redjoj/lriethernet-copy/README.md

Project Documentation:
https://docs.google.com/document/d/17A6YyLQIsLVnjUdbRW_1tglquppojlsUYxg8EC6wMic/edit?tab=t.0
