redjoj/lriethernet-copy/LRIEthernet.kicad_pcb

## KiCad design LRIEthernet.kicad_pcb (2026-02-13)

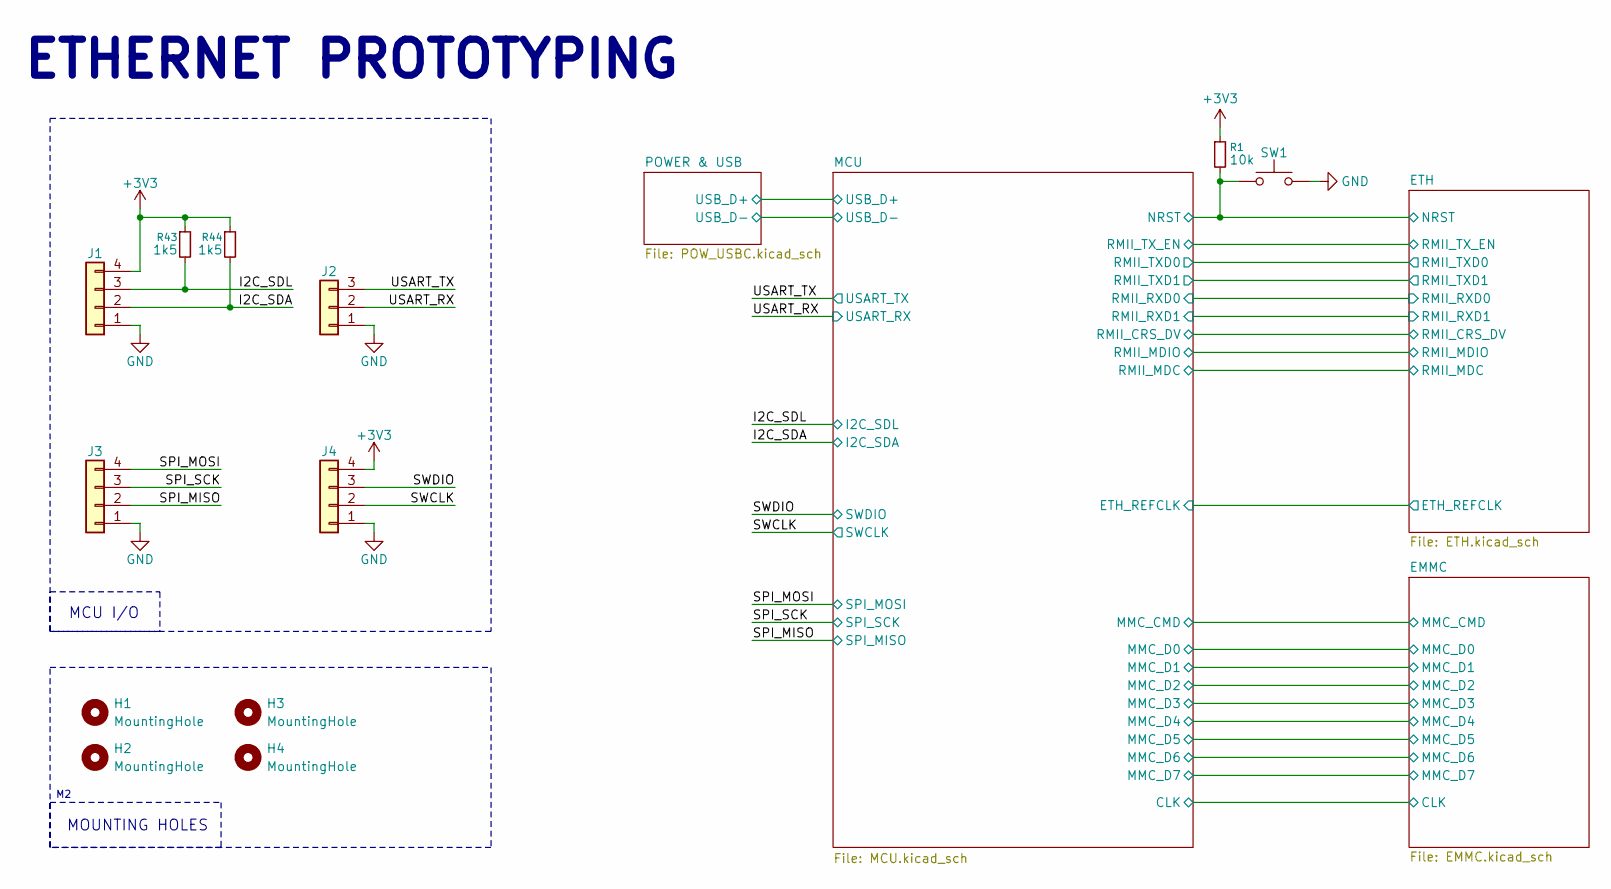
[picture p1: schematic LRIEthernet.kicad_sch, Ethernet Prototyping Hierarchical View]

Parts:
H1, H2, H3, H4: MountingHole; MountingHole_2.2mm_M2
J1, J3, J4: Conn_01x04; PinHeader_1x04_P2.54mm_Vertical
J2: Conn_01x03; PinHeader_1x03_P2.54mm_Vertical
R1: 10k; R_0603_1608Metric
R43, R44: 1k5; R_0603_1608Metric
SW1: SW_Push; SW_TS-1088_XNP

Connections:
+3V3: J1.4, J4.4, R1.1, R43.1, R44.1; also elsewhere on the board
/ETH/NRST: R1.2, SW1.1; also elsewhere on the board
/I2C_SDA: J1.2, R44.2; also elsewhere on the board
/I2C_SDL: J1.3, R43.2; also elsewhere on the board
/SPI_MISO: J3.2; also elsewhere on the board
/SPI_MOSI: J3.4; also elsewhere on the board
/SPI_SCK: J3.3; also elsewhere on the board
/SWCLK: J4.2; also elsewhere on the board
/SWDIO: J4.3; also elsewhere on the board
/USART_RX: J2.2; also elsewhere on the board
/USART_TX: J2.3; also elsewhere on the board
GND: J1.1, J2.1, J3.1, J4.1, SW1.2; also elsewhere on the board

Notes on the sheet:
ETHERNET PROTOTYPING
MCU I/O
MOUNTING HOLES

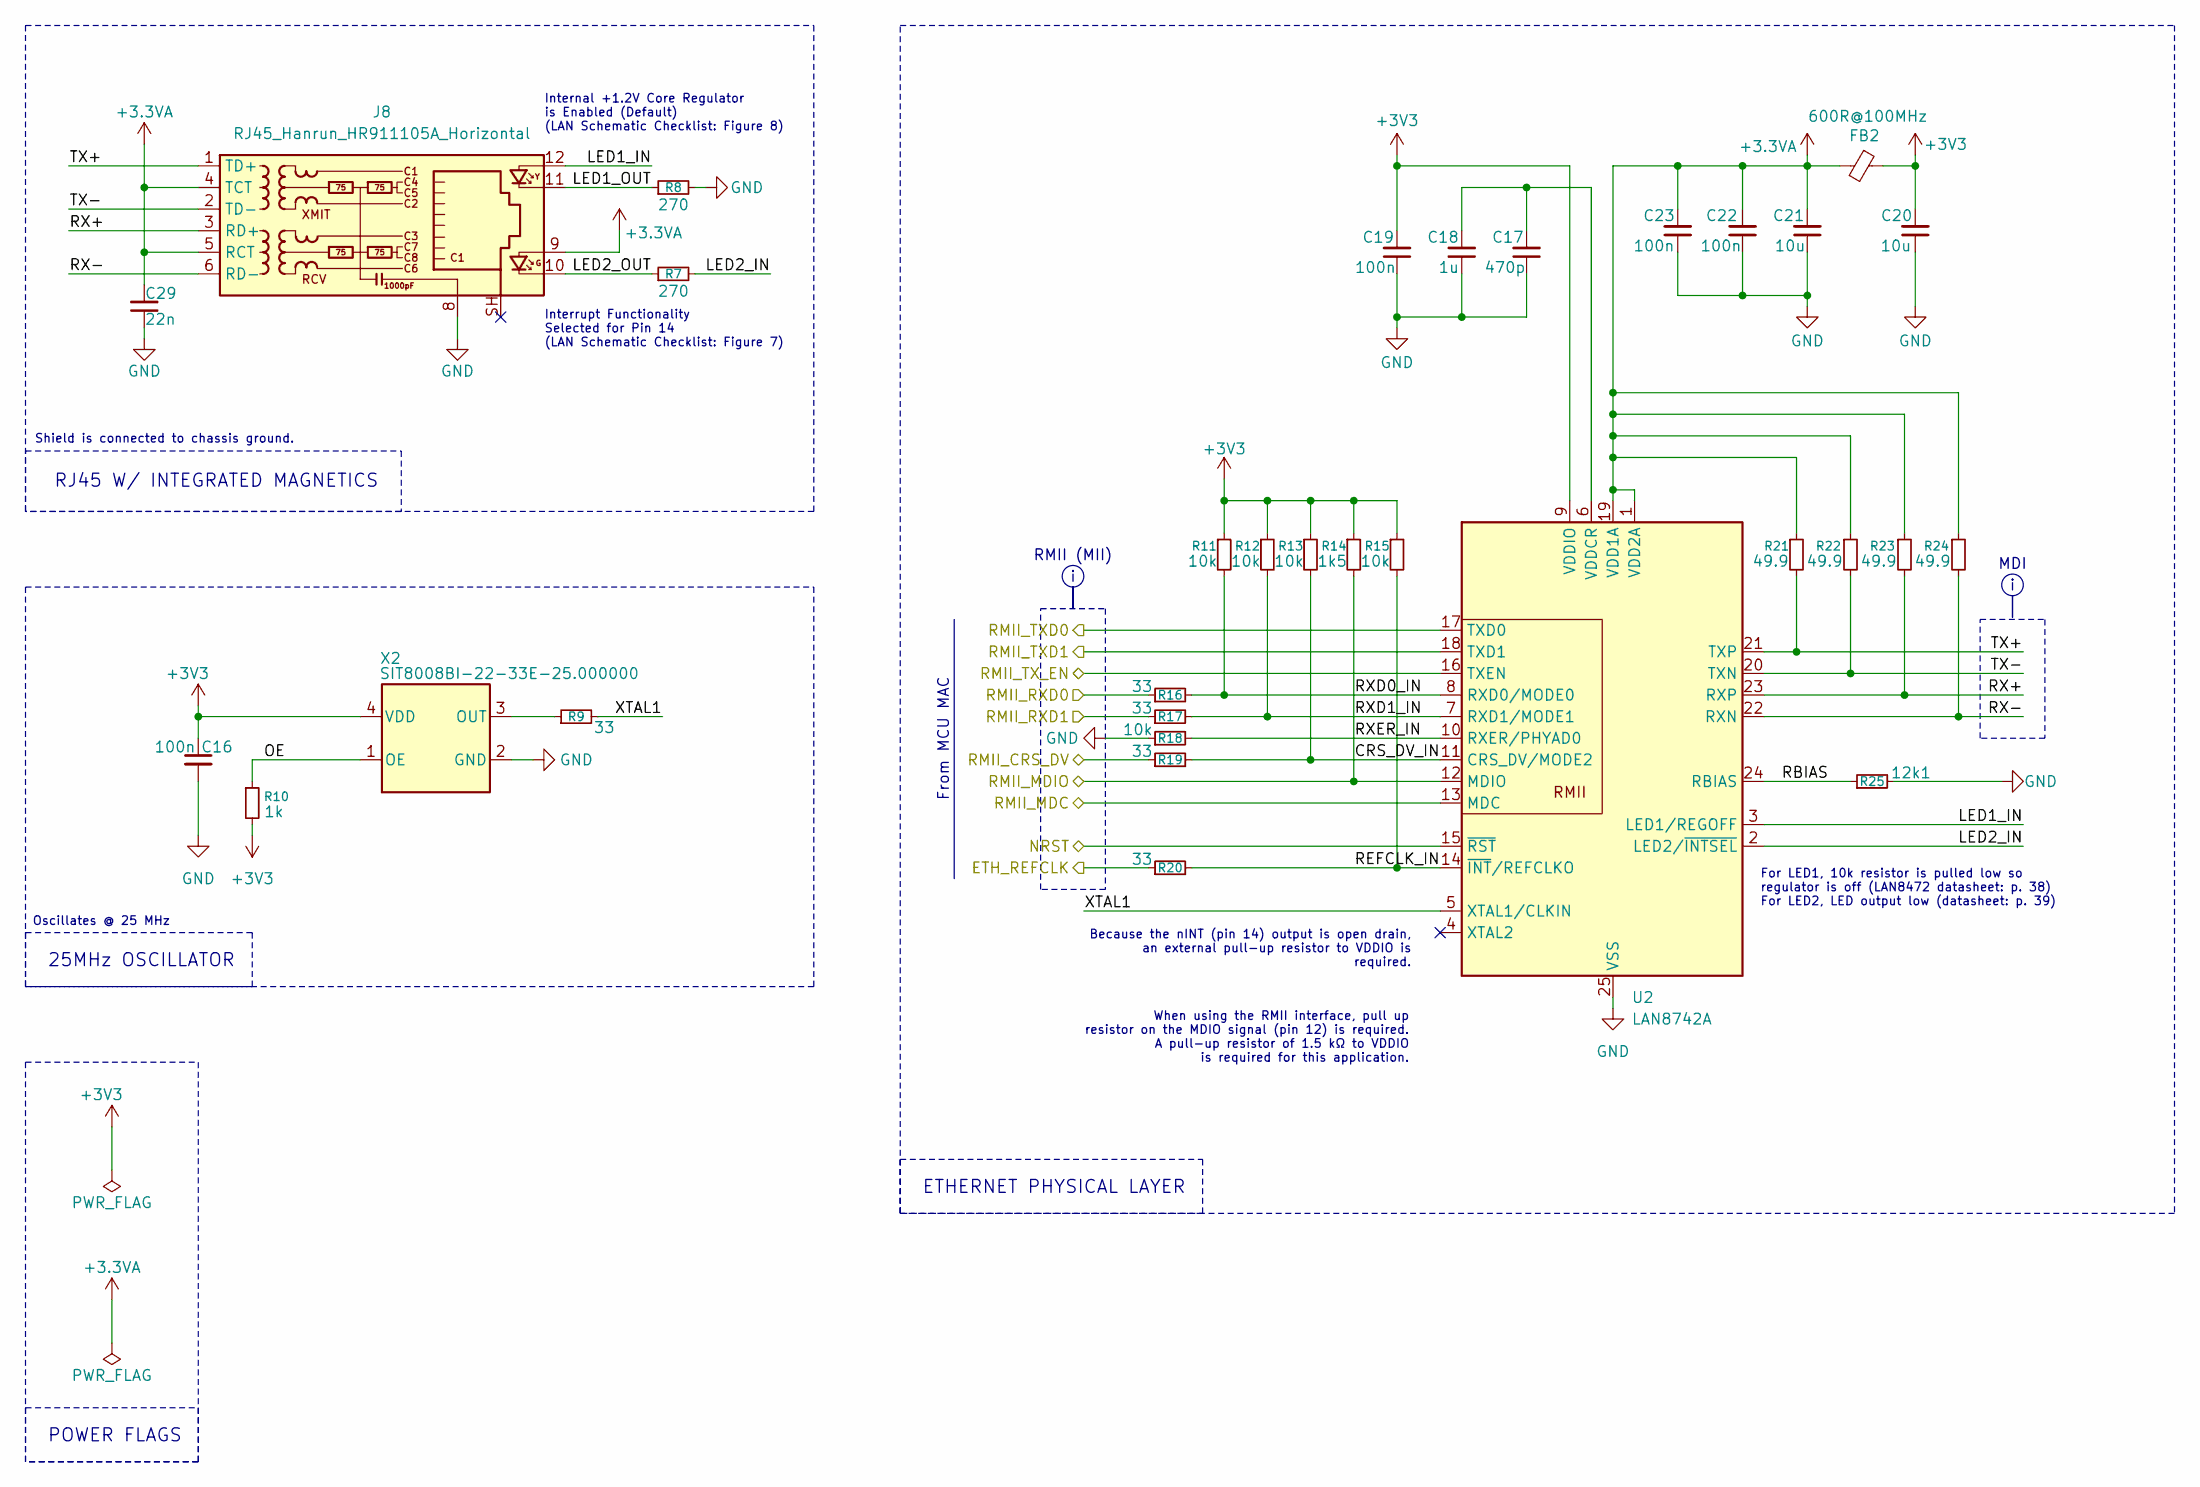
[picture p2: schematic ETH.kicad_sch, Ethernet]

Parts:
C16: 100n; C_0603_1608Metric
C17: 470p; C_0603_1608Metric
C18: 1u; C_0603_1608Metric
C19, C22, C23: 100n; C_0402_1005Metric
C20, C21: 10u; C_0603_1608Metric
C29: 22n; C_0603_1608Metric
FB2: 600R@100MHz; L_0603_1608Metric
J8: RJ45_Hanrun_HR911105A_Horizontal
R7, R8: 270; R_0603_1608Metric
R9, R16, R17, R19, R20: 33; R_0603_1608Metric
R10: 1k; R_0603_1608Metric
R11, R12, R13, R15, R18: 10k; R_0603_1608Metric
R14: 1k5; R_0603_1608Metric
R21, R22, R23, R24: 49.9; R_0603_1608Metric
R25: 12k1; R_0603_1608Metric
U2: LAN8742A; VQFN-24-1EP_4x4mm_P0.5mm_EP2.5x2.5mm_ThermalVias
X2: SIT8008BI-22-33E-25.000000; SON4_SIT8008BI_3.2x2.5_SIT

Connections:
+3.3VA: C21.2, C22.2, C23.2, C29.2, FB2.2, J8.4 (TCT), J8.5 (RCT), J8.9, R21.1, R22.1, R23.1, R24.1, U2.1 (VDD2A), U2.19 (VDD1A)
+3V3: C16.1, C19.2, C20.2, FB2.1, R10.2, R11.1, R12.1, R13.1, R14.1, R15.1, U2.9 (VDDIO), X2.4 (VDD); also elsewhere on the board
/ETH/ETH_REFCLK: R20.1; also elsewhere on the board
/ETH/LED1_IN: J8.12, U2.3 (LED1/REGOFF)
/ETH/LED1_OUT: J8.11, R8.1
/ETH/LED2_IN: R7.2, U2.2 (LED2/~INTSEL)
/ETH/LED2_OUT: J8.10, R7.1
/ETH/NRST: U2.15 (~RST); also elsewhere on the board
/ETH/OE: R10.1, X2.1 (OE)
/ETH/RBIAS: R25.1, U2.24 (RBIAS)
/ETH/REFCLK_IN: R15.2, R20.2, U2.14 (~INT/REFCLKO)
/ETH/RMII_CRS_DV: R19.1; also elsewhere on the board
/ETH/RMII_MDC: U2.13 (MDC); also elsewhere on the board
/ETH/RMII_RXD0: R16.1; also elsewhere on the board
/ETH/RMII_RXD1: R17.1; also elsewhere on the board
/ETH/RMII_TXD0: U2.17 (TXD0); also elsewhere on the board
/ETH/RMII_TXD1: U2.18 (TXD1); also elsewhere on the board
/ETH/RMII_TX_EN: U2.16 (TXEN); also elsewhere on the board
/ETH/RX+: J8.3 (RD+), R23.2, U2.23 (RXP)
/ETH/RX-: J8.6 (RD-), R24.2, U2.22 (RXN)
/ETH/TX+: J8.1 (TD+), R21.2, U2.21 (TXP)
/ETH/TX-: J8.2 (TD-), R22.2, U2.20 (TXN)
/ETH/XTAL1: R9.2, U2.5 (XTAL1/CLKIN)
GND: C16.2, C17.1, C18.1, C19.1, C20.1, C21.1, C22.1, C23.1, C29.1, J8.8, R8.2, R18.1, R25.2, U2.25 (VSS), X2.2 (GND); also elsewhere on the board
unnamed: C17.2, C18.2, U2.6 (VDDCR)
unnamed: R9.1, X2.3 (OUT)

Notes on the sheet:
POWER FLAGS
From MCU MAC
ETHERNET PHYSICAL LAYER
RJ45 W/ INTEGRATED MAGNETICS
Shield is connected to chassis ground.
For LED1, 10k resistor is pulled low so regulator is off (LAN8472 datasheet: p. 38) For LED2, LED output low (datasheet: p. 39)
Interrupt Functionality Selected for Pin 14 (LAN Schematic Checklist: Figure 7)
When using the RMII interface, pull up resistor on the MDIO signal (pin 12) is required. A pull-up resistor of 1.5 kΩ to VDDIO is required for this application.
RMII (MII)
25MHz OSCILLATOR
Oscillates @ 25 MHz
MDI
Internal +1.2V Core Regulator is Enabled (Default) (LAN Schematic Checklist: Figure 8)
Because the nINT (pin 14) output is open drain, an external pull-up resistor to VDDIO is required.

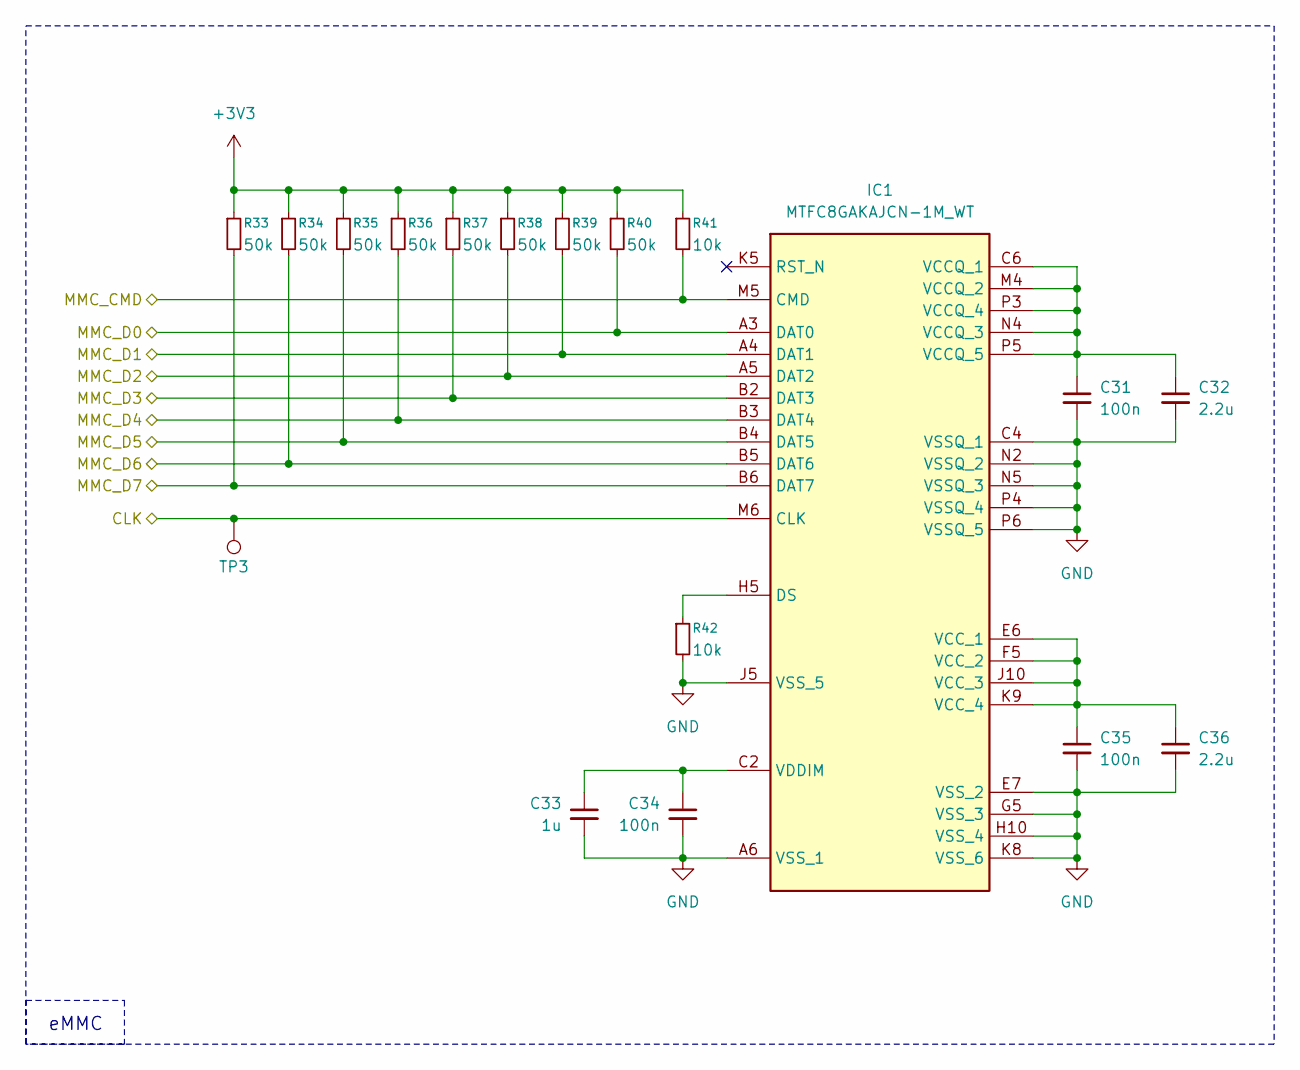
[picture p3: schematic EMMC.kicad_sch]

Parts:
C31, C34, C35: 100n; C_0402_1005Metric
C32, C36: 2.2u; C_0603_1608Metric
C33: 1u; C_0603_1608Metric
IC1: MTFC8GAKAJCN-1M_WT; VFBGA153_11p5X13p0X1p0_CN_MRN; Manufacturer_Part_Number MTFC8GAKAJCN-1M WT; Mouser Part Number 340-296537-TRAY
R33, R34, R35, R36, R37, R38, R39, R40: 50k; R_0603_1608Metric
R41, R42: 10k; R_0603_1608Metric
TP3: TestPoint; TestPoint_Pad_D1.0mm

Connections:
+3V3: R33.1, R34.1, R35.1, R36.1, R37.1, R38.1, R39.1, R40.1, R41.1; also elsewhere on the board
/EMMC/CLK: IC1.M6 (CLK), TP3.1; also elsewhere on the board
/EMMC/MMC_CMD: IC1.M5 (CMD), R41.2; also elsewhere on the board
/EMMC/MMC_D0: IC1.A3 (DAT0), R40.2; also elsewhere on the board
/EMMC/MMC_D1: IC1.A4 (DAT1), R39.2; also elsewhere on the board
/EMMC/MMC_D2: IC1.A5 (DAT2), R38.2; also elsewhere on the board
/EMMC/MMC_D3: IC1.B2 (DAT3), R37.2; also elsewhere on the board
/EMMC/MMC_D4: IC1.B3 (DAT4), R36.2; also elsewhere on the board
/EMMC/MMC_D5: IC1.B4 (DAT5), R35.2; also elsewhere on the board
/EMMC/MMC_D6: IC1.B5 (DAT6), R34.2; also elsewhere on the board
/EMMC/MMC_D7: IC1.B6 (DAT7), R33.2; also elsewhere on the board
GND: C31.2, C32.2, C33.2, C34.2, C35.2, C36.2, IC1.A6 (VSS_1), IC1.C4 (VSSQ_1), IC1.E7 (VSS_2), IC1.G5 (VSS_3), IC1.H10 (VSS_4), IC1.J5 (VSS_5), IC1.K8 (VSS_6), IC1.N2 (VSSQ_2), IC1.N5 (VSSQ_3), IC1.P4 (VSSQ_4), IC1.P6 (VSSQ_5), R42.2; also elsewhere on the board
unnamed: IC1.H5 (DS), R42.1
unnamed: C31.1, C32.1, IC1.C6 (VCCQ_1), IC1.M4 (VCCQ_2), IC1.N4 (VCCQ_3), IC1.P3 (VCCQ_4), IC1.P5 (VCCQ_5)
unnamed: C35.1, C36.1, IC1.E6 (VCC_1), IC1.F5 (VCC_2), IC1.J10 (VCC_3), IC1.K9 (VCC_4)
unnamed: C33.1, C34.1, IC1.C2 (VDDIM)

Notes on the sheet:
eMMC

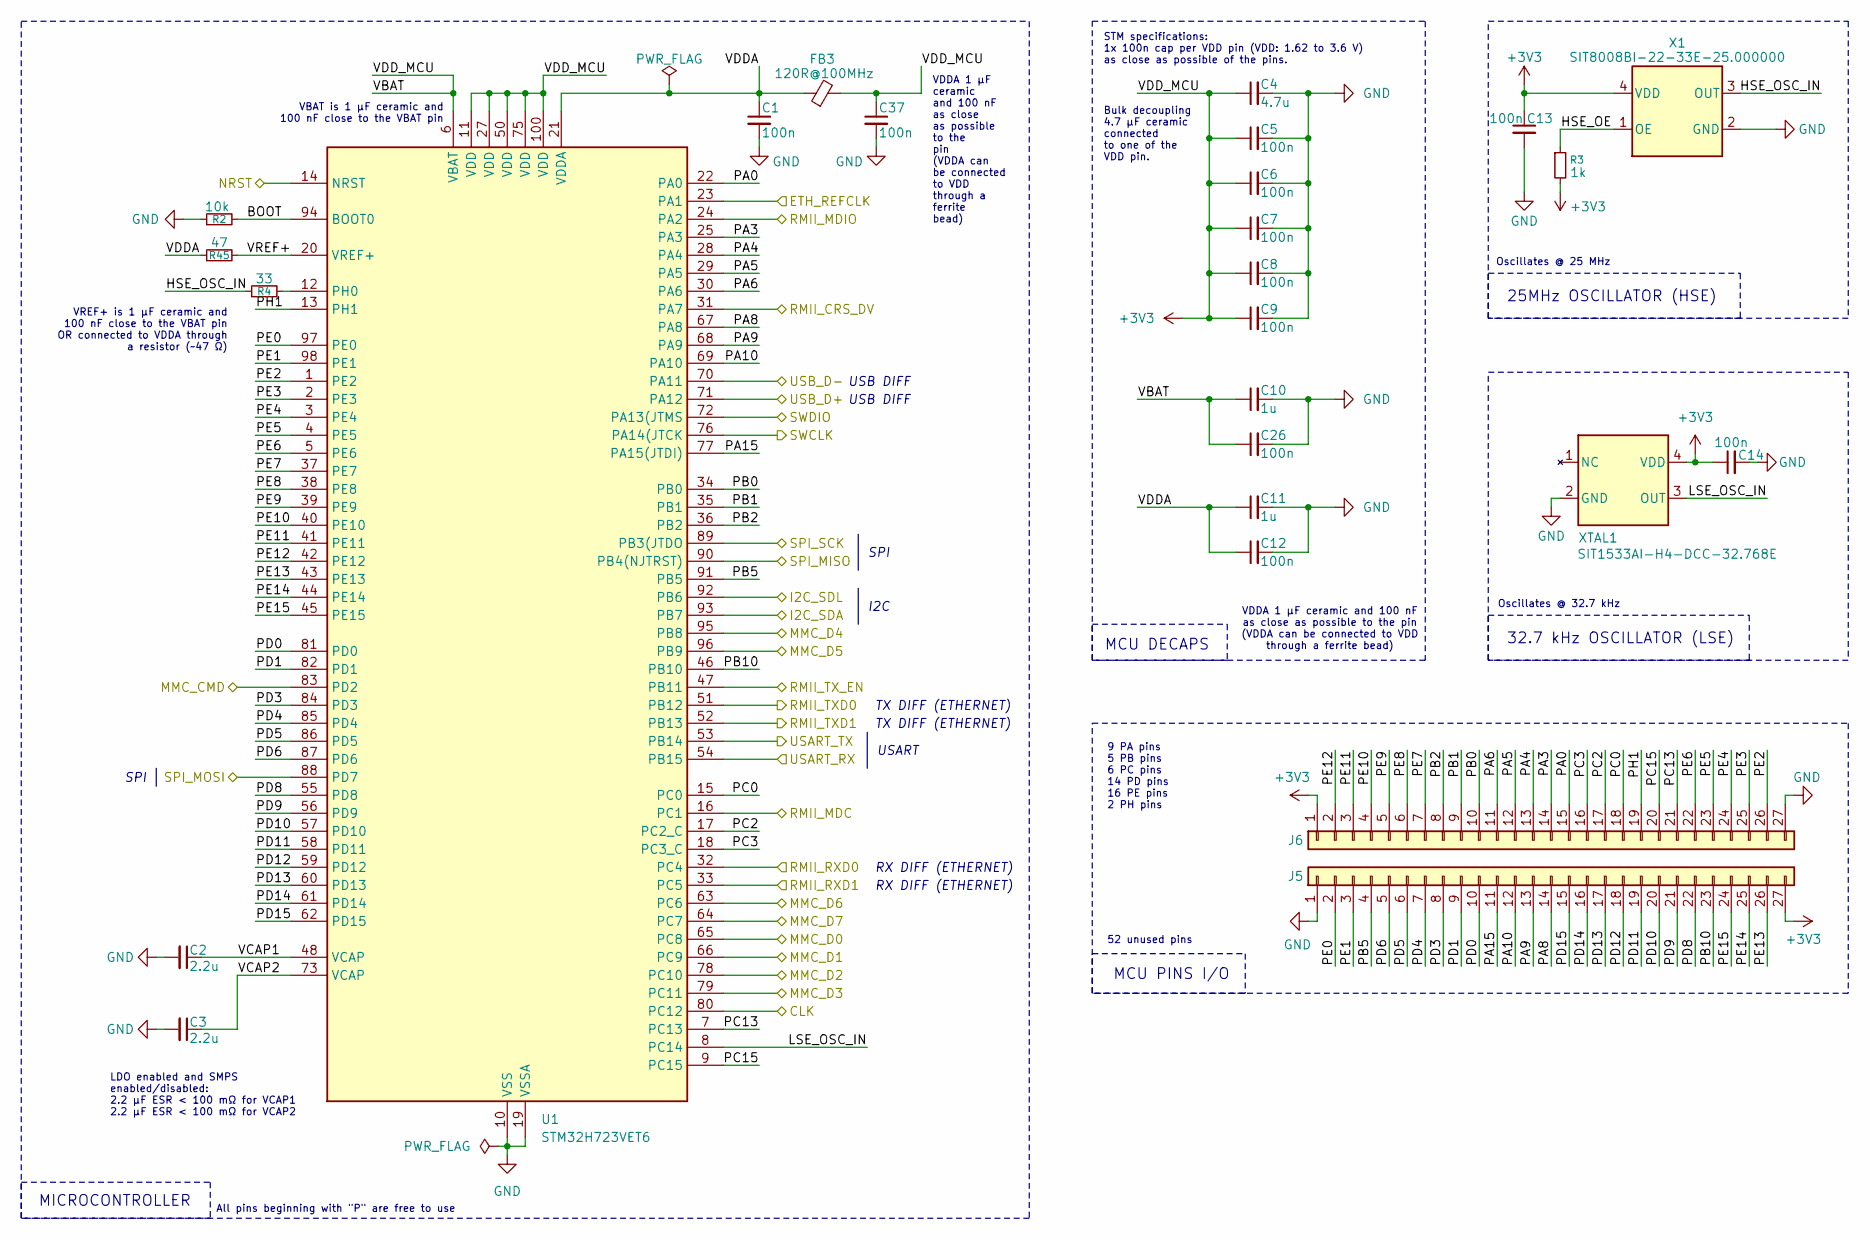
[picture p4: schematic MCU.kicad_sch, Microcontroller]

Parts:
C1, C5, C6, C7, C8, C9, C12, C13, C14, C26, C37: 100n; C_0402_1005Metric
C2, C3: 2.2u; C_0603_1608Metric
C4: 4.7u; C_0603_1608Metric
C10, C11: 1u; C_0603_1608Metric
FB3: 120R@100MHz; L_0603_1608Metric
J5, J6: Conn_01x27; PinHeader_1x27_P2.54mm_Vertical
R2: 10k; R_0603_1608Metric
R3: 1k; R_0603_1608Metric
R4: 33; R_0603_1608Metric
R45: 47; R_0603_1608Metric
U1: STM32H723VET6; LQFP-100_14x14mm_P0.5mm
X1: SIT8008BI-22-33E-25.000000; SON4_SIT8008BI_3.2x2.5_SIT
XTAL1: SIT1533AI-H4-DCC-32.768E; XTAL4_SiT1533_SIT

Connections:
+3V3: C4.1, C5.1, C6.1, C7.1, C8.1, C9.1, C10.1, C13.1, C14.1, C26.1, C37.1, FB3.2, J5.27, J6.1, R3.2, U1.6 (VBAT), U1.11 (VDD), U1.27 (VDD), U1.50 (VDD), U1.75 (VDD), U1.100 (VDD), X1.4 (VDD), XTAL1.4 (VDD); also elsewhere on the board
/EMMC/CLK: U1.80 (PC12); also elsewhere on the board
/EMMC/MMC_CMD: U1.83 (PD2); also elsewhere on the board
/EMMC/MMC_D0: U1.65 (PC8); also elsewhere on the board
/EMMC/MMC_D1: U1.66 (PC9); also elsewhere on the board
/EMMC/MMC_D2: U1.78 (PC10); also elsewhere on the board
/EMMC/MMC_D3: U1.79 (PC11); also elsewhere on the board
/EMMC/MMC_D4: U1.95 (PB8); also elsewhere on the board
/EMMC/MMC_D5: U1.96 (PB9); also elsewhere on the board
/EMMC/MMC_D6: U1.63 (PC6); also elsewhere on the board
/EMMC/MMC_D7: U1.64 (PC7); also elsewhere on the board
/ETH/ETH_REFCLK: U1.23 (PA1); also elsewhere on the board
/ETH/NRST: U1.14 (NRST); also elsewhere on the board
/ETH/RMII_CRS_DV: U1.31 (PA7); also elsewhere on the board
/ETH/RMII_MDC: U1.16 (PC1); also elsewhere on the board
/ETH/RMII_RXD0: U1.32 (PC4); also elsewhere on the board
/ETH/RMII_RXD1: U1.33 (PC5); also elsewhere on the board
/ETH/RMII_TXD0: U1.51 (PB12); also elsewhere on the board
/ETH/RMII_TXD1: U1.52 (PB13); also elsewhere on the board
/ETH/RMII_TX_EN: U1.47 (PB11); also elsewhere on the board
/I2C_SDA: U1.93 (PB7); also elsewhere on the board
/I2C_SDL: U1.92 (PB6); also elsewhere on the board
/MCU/BOOT: R2.2, U1.94 (BOOT0)
/MCU/HSE_OE: R3.1, X1.1 (OE)
/MCU/HSE_OSC_IN: R4.1, X1.3 (OUT)
/MCU/LSE_OSC_IN: U1.8 (PC14), XTAL1.3 (OUT)
/MCU/PA0: J6.15, U1.22 (PA0)
/MCU/PA3: J6.14, U1.25 (PA3)
/MCU/PA4: J6.13, U1.28 (PA4)
/MCU/PA5: J6.12, U1.29 (PA5)
/MCU/PA6: J6.11, U1.30 (PA6)
/MCU/PA8: J5.14, U1.67 (PA8)
/MCU/PA9: J5.13, U1.68 (PA9)
/MCU/PA10: J5.12, U1.69 (PA10)
/MCU/PA15: J5.11, U1.77 (PA15(JTDI))
/MCU/PB0: J6.10, U1.34 (PB0)
/MCU/PB1: J6.9, U1.35 (PB1)
/MCU/PB2: J6.8, U1.36 (PB2)
/MCU/PB5: J5.4, U1.91 (PB5)
/MCU/PB10: J5.23, U1.46 (PB10)
/MCU/PC0: J6.18, U1.15 (PC0)
/MCU/PC2: J6.17, U1.17 (PC2_C)
/MCU/PC3: J6.16, U1.18 (PC3_C)
/MCU/PC13: J6.21, U1.7 (PC13)
/MCU/PC15: J6.20, U1.9 (PC15)
/MCU/PD0: J5.10, U1.81 (PD0)
/MCU/PD1: J5.9, U1.82 (PD1)
/MCU/PD3: J5.8, U1.84 (PD3)
/MCU/PD4: J5.7, U1.85 (PD4)
/MCU/PD5: J5.6, U1.86 (PD5)
/MCU/PD6: J5.5, U1.87 (PD6)
/MCU/PD8: J5.22, U1.55 (PD8)
/MCU/PD9: J5.21, U1.56 (PD9)
/MCU/PD10: J5.20, U1.57 (PD10)
/MCU/PD11: J5.19, U1.58 (PD11)
/MCU/PD12: J5.18, U1.59 (PD12)
/MCU/PD13: J5.17, U1.60 (PD13)
/MCU/PD14: J5.16, U1.61 (PD14)
/MCU/PD15: J5.15, U1.62 (PD15)
/MCU/PE0: J5.2, U1.97 (PE0)
/MCU/PE1: J5.3, U1.98 (PE1)
/MCU/PE2: J6.26, U1.1 (PE2)
/MCU/PE3: J6.25, U1.2 (PE3)
/MCU/PE4: J6.24, U1.3 (PE4)
/MCU/PE5: J6.23, U1.4 (PE5)
/MCU/PE6: J6.22, U1.5 (PE6)
/MCU/PE7: J6.7, U1.37 (PE7)
/MCU/PE8: J6.6, U1.38 (PE8)
/MCU/PE9: J6.5, U1.39 (PE9)
/MCU/PE10: J6.4, U1.40 (PE10)
/MCU/PE11: J6.3, U1.41 (PE11)
/MCU/PE12: J6.2, U1.42 (PE12)
/MCU/PE13: J5.26, U1.43 (PE13)
/MCU/PE14: J5.25, U1.44 (PE14)
/MCU/PE15: J5.24, U1.45 (PE15)
/MCU/PH1: J6.19, U1.13 (PH1)
/MCU/USB_D+: U1.71 (PA12); also elsewhere on the board
/MCU/USB_D-: U1.70 (PA11); also elsewhere on the board
/MCU/VCAP1: C2.1, U1.48 (VCAP)
/MCU/VCAP2: C3.1, U1.73 (VCAP)
/MCU/VDDA: C1.1, C11.1, C12.1, FB3.1, R45.1, U1.21 (VDDA)
/MCU/VREF+: R45.2, U1.20 (VREF+)
/SPI_MISO: U1.90 (PB4(NJTRST)); also elsewhere on the board
/SPI_MOSI: U1.88 (PD7); also elsewhere on the board
/SPI_SCK: U1.89 (PB3(JTDO); also elsewhere on the board
/SWCLK: U1.76 (PA14(JTCK); also elsewhere on the board
/SWDIO: U1.72 (PA13(JTMS); also elsewhere on the board
/USART_RX: U1.54 (PB15); also elsewhere on the board
/USART_TX: U1.53 (PB14); also elsewhere on the board
GND: C1.2, C2.2, C3.2, C4.2, C5.2, C6.2, C7.2, C8.2, C9.2, C10.2, C11.2, C12.2, C13.2, C14.2, C26.2, C37.2, J5.1, J6.27, R2.1, U1.10 (VSS), U1.19 (VSSA), U1.26 (VSS), U1.49 (VSS), U1.74 (VSS), U1.99 (VSS), X1.2 (GND), XTAL1.2 (GND); also elsewhere on the board
unnamed: R4.2, U1.12 (PH0)

Notes on the sheet:
STM specifications: 1x 100n cap per VDD pin (VDD: 1.62 to 3.6 V) as close as possible of the pins.
Oscillates @ 25 MHz
VREF+ is 1 μF ceramic and 100 nF close to the VBAT pin OR connected to VDDA through a resistor (~47 Ω)
Oscillates @ 32.7 kHz
VDDA 1 μF ceramic and 100 nF as close as possible to the pin (VDDA can be connected to VDD through a ferrite bead)
RX DIFF (ETHERNET)
USART
USB DIFF
All pins beginning with "P" are free to use
VDDA 1 μF ceramic and 100 nF as close as possible to the pin (VDDA can be connected to VDD through a ferrite bead)
MICROCONTROLLER
TX DIFF (ETHERNET)
LDO enabled and SMPS enabled/disabled: 2.2 μF ESR < 100 mΩ for VCAP1 2.2 μF ESR < 100 mΩ for VCAP2
I2C
TX DIFF (ETHERNET)
SPI
MCU PINS I/O
52 unused pins
32.7 kHz OSCILLATOR (LSE)
9 PA pins 5 PB pins 6 PC pins 14 PD pins 16 PE pins 2 PH pins
Bulk decoupling 4.7 μF ceramic connected to one of the VDD pin.
MCU DECAPS
VBAT is 1 μF ceramic and 100 nF close to the VBAT pin
25MHz OSCILLATOR (HSE)

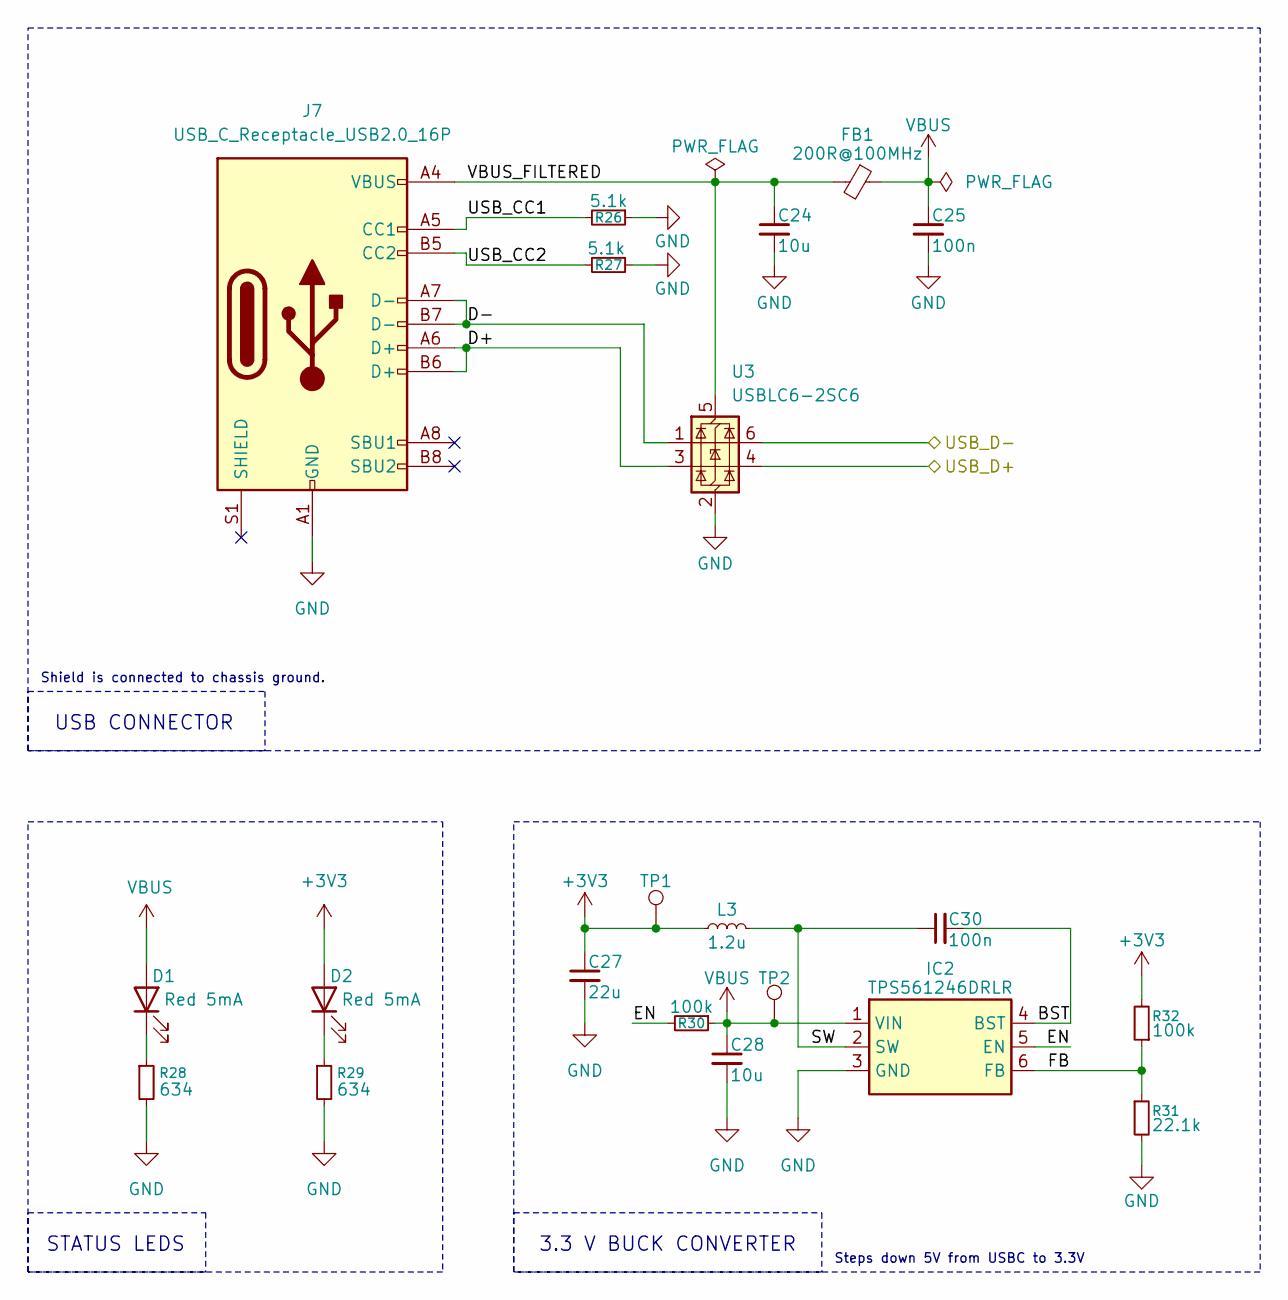
[picture p5: schematic POW_USBC.kicad_sch, Power and USB]

Parts:
C24: 10u; C_0603_1608Metric
C25, C30: 100n; C_0603_1608Metric
C27: 22u; C_0805_2012Metric
C28: 10u; C_0805_2012Metric
D1, D2: Red 5mA; LED_0603_1608Metric
FB1: 200R@100MHz; L_0603_1608Metric
IC2: TPS561246DRLR; SOT-563; Mouser Part Number 595-TPS561246DRLR
J7: USB_C_Receptacle_USB2.0_16P; USB_C_Receptacle_GCT_USB4110
L3: 1.2u; L_0603_1608Metric
R26, R27: 5.1k; R_0603_1608Metric
R28, R29: 634; R_0603_1608Metric
R30, R32: 100k; R_0603_1608Metric
R31: 22.1k; R_0603_1608Metric
TP1, TP2: TestPoint; TestPoint_Pad_D1.0mm
U3: USBLC6-2SC6; SOT-23-6

Connections:
+3V3: C27.1, D2.2 (A), L3.1, R32.2, TP1.1; also elsewhere on the board
/MCU/USB_D+: U3.4 (I/O2); also elsewhere on the board
/MCU/USB_D-: U3.6 (I/O1); also elsewhere on the board
/POWER & USB/BST: C30.2, IC2.4 (BST)
/POWER & USB/D+: J7.A6 (D+), J7.B6 (D+), U3.3 (I/O2)
/POWER & USB/D-: J7.A7 (D-), J7.B7 (D-), U3.1 (I/O1)
/POWER & USB/EN: IC2.5 (EN), R30.2
/POWER & USB/FB: IC2.6 (FB), R31.1, R32.1
/POWER & USB/SW: C30.1, IC2.2 (SW), L3.2
/POWER & USB/USB_CC1: J7.A5 (CC1), R26.2
/POWER & USB/USB_CC2: J7.B5 (CC2), R27.2
/POWER & USB/VBUS_FILTERED: C24.1, FB1.2, J7.A4 (VBUS), J7.A9 (VBUS), J7.B4 (VBUS), J7.B9 (VBUS), U3.5 (VBUS)
GND: C24.2, C25.2, C27.2, C28.2, IC2.3 (GND), J7.A1 (GND), J7.A12 (GND), J7.B1 (GND), J7.B12 (GND), R26.1, R27.1, R28.2, R29.2, R31.2, U3.2 (GND); also elsewhere on the board
unnamed: D1.1 (K), R28.1
unnamed: D2.1 (K), R29.1
VBUS: C25.1, C28.1, D1.2 (A), FB1.1, IC2.1 (VIN), R30.1, TP2.1

Notes on the sheet:
Shield is connected to chassis ground.
USB CONNECTOR
STATUS LEDS
3.3 V BUCK CONVERTER
Steps down 5V from USBC to 3.3V

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
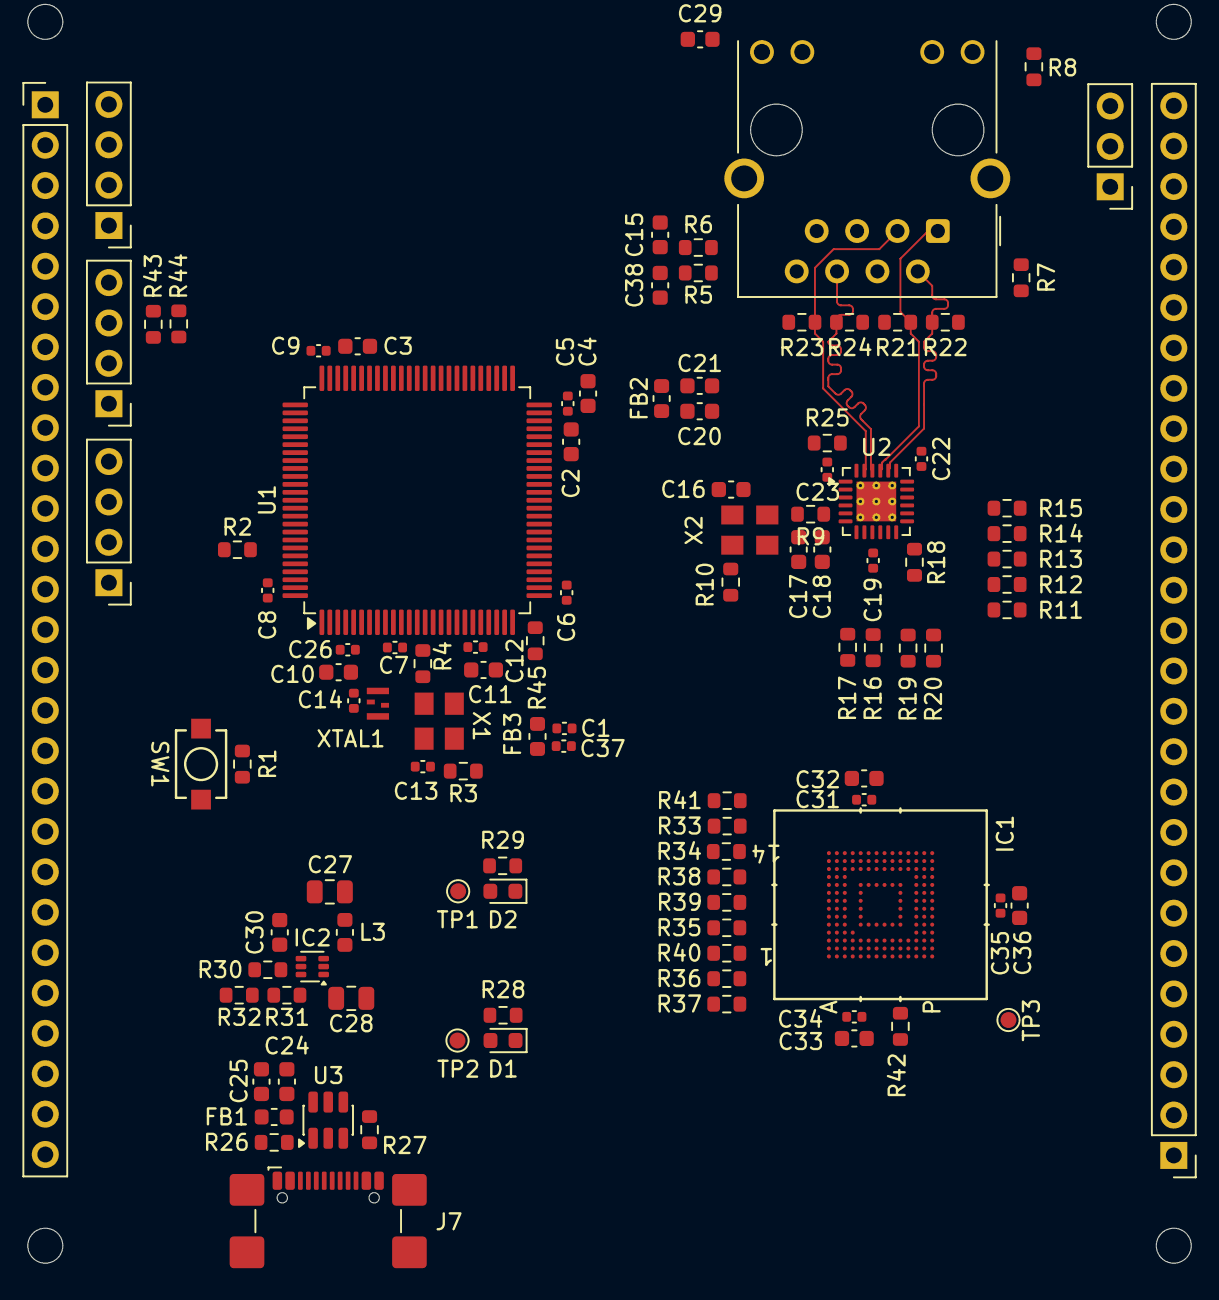
[picture p6: board LRIEthernet.kicad_pcb from above]

Board: 4 copper layers, 113 parts (0 on the bottom side), 129 nets.

Other parts of the board:
C15, C38: 1n; C_0603_1608Metric
R5, R6: 75; R_0603_1608Metric

Their connections:
GND: C15.2, C38.2; also elsewhere on the board
unnamed: C15.1, R6.1
unnamed: C38.1, R5.1
